craftvia/craftvia-core-s-g431/docs/images/2D_PCB1_front_2026-10-26.png

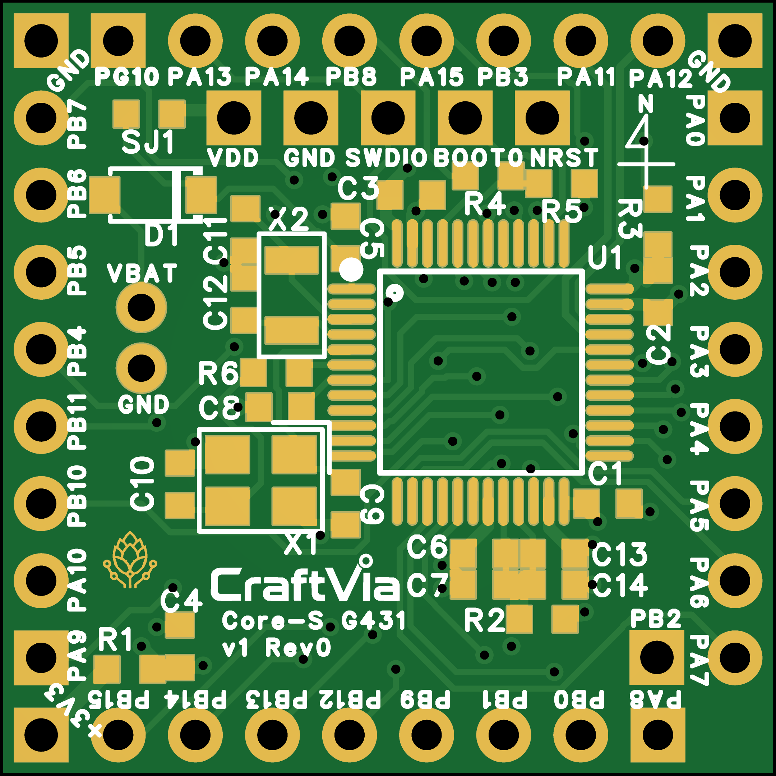
docs/images/2D_PCB1_front_2026-10-26.png
