craftvia/craftvia-core-s-g431/assembly/CraftVia-Core-S-G431-v1-Rev0-Assembly.pdf

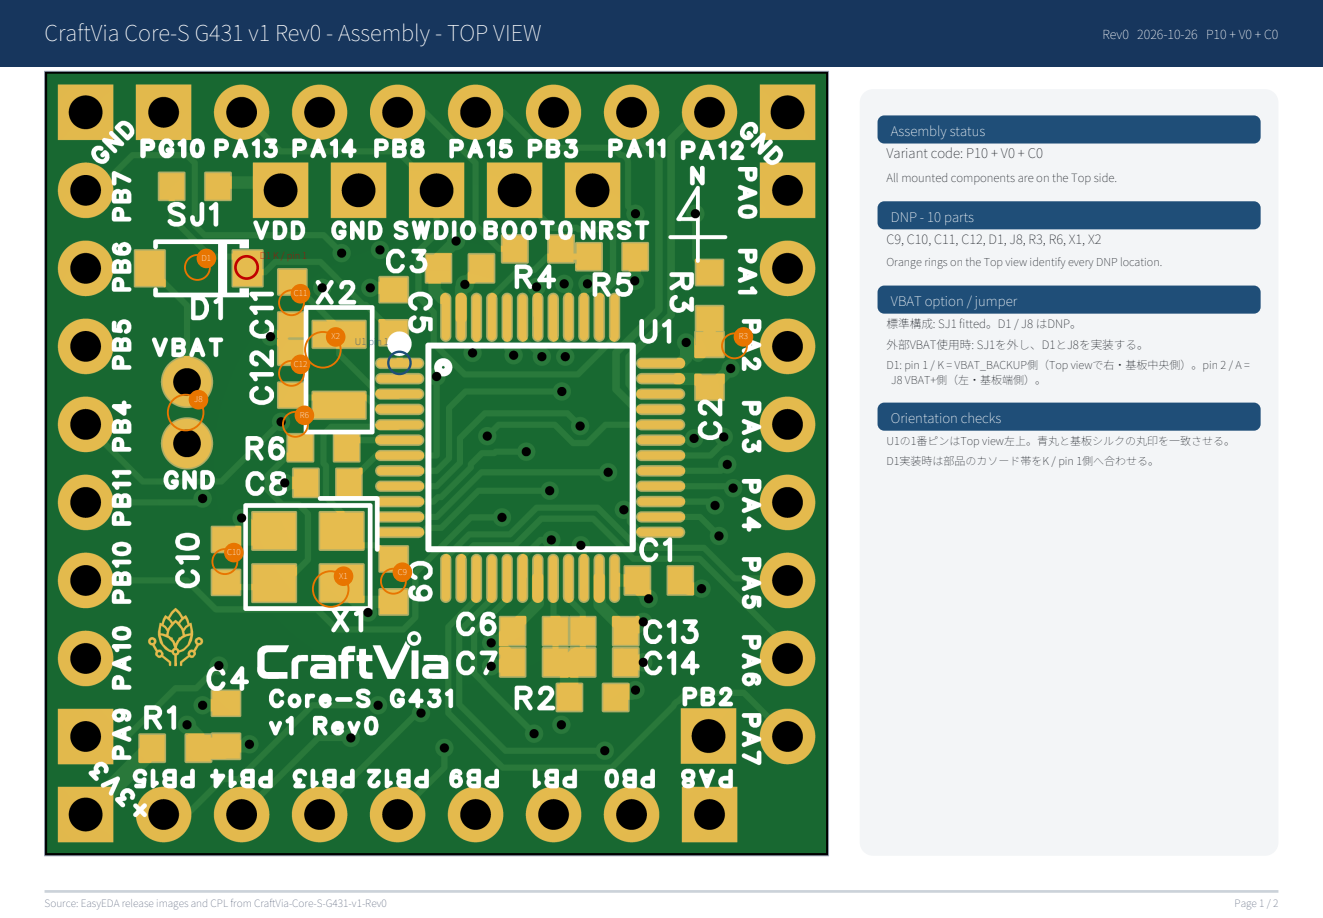
[picture p4: page 1]

All mounted components are on the Top side.

Orange rings on the Top view identify every DNP location.

標準構成: SJ1 fitted。D1 / J8 はDNP。
外部VBAT使用時: SJ1を外し、D1とJ8を実装する。
D1: pin 1 / K = VBAT_BACKUP側（Top viewで右・基板中央側）。pin 2 / A =
J8 VBAT+側（左・基板端側）。

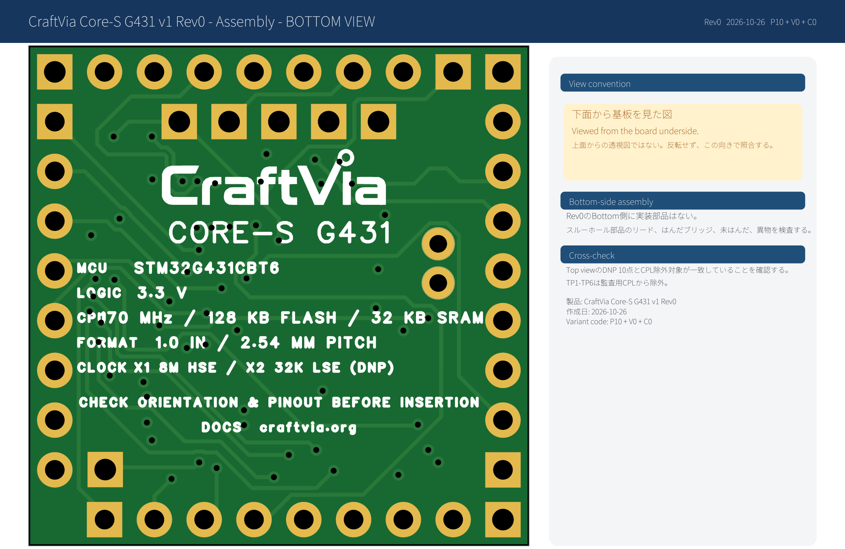
[picture p5: figure]
View convention; 下面から基板を見た図; Viewed from the board underside.; 上面からの透視図ではない。反転せず、この向きで照合する。; Bottom-side assembly; Rev0のBottom側に実装部品はない。; スルーホール部品のリード、はんだブリッジ、未はんだ、異物を検査する。; Cross-check; Top viewのDNP 10点とCPL除外対象が一致していることを確認する。; TP1-TP6は監査用CPLから除外。; 製品: CraftVia Core-S G431 v1 Rev0 作成日: 2026-10-26 Variant code: P10 + V0 + C0

CraftVia Core-S G431 v1 Rev0 - Assembly - BOTTOM VIEW | Rev0 2026-10-26 P10 + V0 + C0
Source: EasyEDA release images and CPL from CraftVia-Core-S-G431-v1-Rev0 | Page 2 / 2

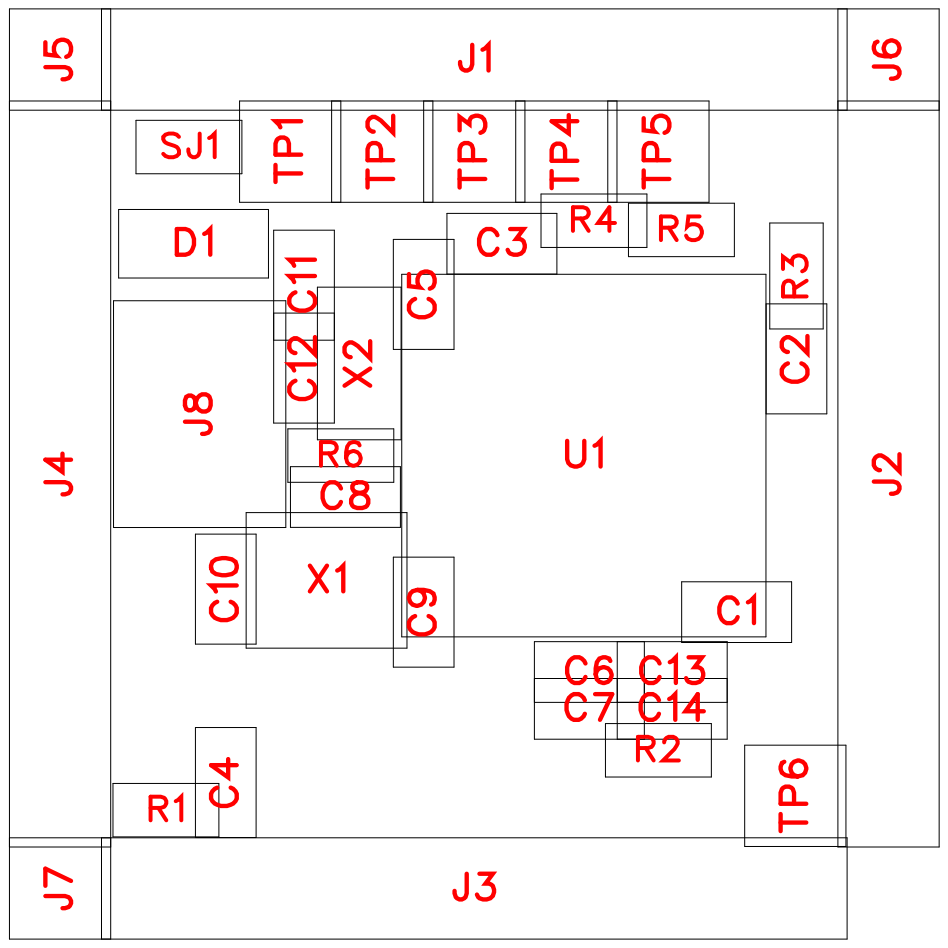
[picture p6: page 3]

C6 | C13
R2

No. | Quantity | Comment | Designator | Footprint | Value | Manufacturer Part | Manufacturer | Supplier Part | Supplier | LCSC Part Name
1 | 3 | 100nF VDD | C1,C2,C3 | C0603 | 100nF | CC0603KRX 7R9BB104 | YAGEO(国巨 ) | CC0603KRX 7R9BB104.1 | LCSC
2 | 1 | 4.7uF bulk | C4 | C0603 | 4.7uF | CL10A475K O8NNNC | SAMSUNG( ) 三星 | CL10A475K O8NNNC.1 | LCSC
3 | 1 | 100nF VBAT | C5 | C0603 | 100nF | CC0603KRX 7R9BB104 | YAGEO(国巨 ) | CC0603KRX 7R9BB104.1 | LCSC
4 | 1 | 100nF VREF+ | C6 | C0603 | 100nF | CC0603KRX 7R9BB104 | YAGEO(国巨 ) | CC0603KRX 7R9BB104.1 | LCSC
5 | 1 | 1uF VREF+ | C7 | C0603 | 1uF | CL10A105KB 8NNNC | SAMSUNG( 三星 ) | CL10A105KB 8NNNC.1 | LCSC
6 | 1 | 100nF NRST | C8 | C0603 | 100nF | CC0603KRX 7R9BB104 | YAGEO(国巨 ) | CC0603KRX 7R9BB104.1 | LCSC
7 | 2 | 18pF HSE load (DNP, tune) | C9,C10 | C0603 | 18pF | CL10C180JB 8NNNC | SAMSUNG( ) 三星 | CL10C180JB 8NNNC.1 | LCSC
8 | 2 | 10pF LSE load (DNP, tune) | C11,C12 | C0603 | 10pF | CL10C100JB 8NNNC | SAMSUNG( ) 三星 | CL10C100JB 8NNNC.1 | LCSC
9 | 1 | 100nF VDDA | C13 | C0603 | 100nF | CC0603KRX 7R9BB104 | YAGEO(国巨 ) | C14663 | LCSC | 100nF ±10% 50V
10 | 1 | 1uF VDDA | C14 | C0603 | 1uF | CL10A105KB 8NNNC | SAMSUNG( 三星 ) | CL10A105KB 8NNNC.1 | LCSC
11 | 1 | BAS116GWJ VBAT isolation (DNP) | D1 | SOD-123_L2 .8-W1.6-LS3. 7-RD | | BAS116GWJ | Nexperia( 安 世 ) | BAS116GWJ .1 | LCSC | 85V 215mA
12 | 1 | N 1-8 | J1 | HDR-TH_8P-P2.54-V-M | | 直排针2.54m m 1*8P | | Header2.54m m 1*8P.1 | LCSC
13 | 1 | E 1-8 | J2 | HDR-TH_8P-P2.54-V-M | | 直排针2.54m m 1*8P | | Header2.54m m 1*8P.1 | LCSC
14 | 1 | S 1-8 | J3 | HDR-TH_8P-P2.54-V-M | | 直排针2.54m m 1*8P | | Header2.54m m 1*8P.1 | LCSC
15 | 1 | W 1-8 | J4 | HDR-TH_8P-P2.54-V-M | | 直排针2.54m m 1*8P | | Header2.54m m 1*8P.1 | LCSC
16 | 1 | K-NW | J5 | HDR-TH_1P-P2.54-V-M | | 2.54-1*1P 针 | BOOMELE( 博穆精密 ) | Header-Male -2.54_1x1.1 | LCSC
17 | 1 | K-NE | J6 | HDR-TH_1P-P2.54-V-M | | 2.54-1*1P 针 | BOOMELE( 博穆精密 ) | Header-Male -2.54_1x1.1 | LCSC
18 | 1 | K-SW | J7 | HDR-TH_1P-P2.54-V-M | | 2.54-1*1P 针 | BOOMELE( 博穆精密 ) | Header-Male -2.54_1x1.1 | LCSC
19 | 1 | VBAT IN (PH 2.0mm) | J8 | CONN-TH_B 2B-PH-K-S | | XY-B2B-PH-K-S | XYECONN( ) 辛译 | XY-B2B-PH-K-S.1 | LCSC
20 | 1 | 0R / FB VDD | R1 | R0603 | 0R | 0603WAF00 00T5E | UNI-ROYAL( ) 厚声 | 0603WAF00 00T5E.1 | LCSC
21 | 1 | 0R / FB VDDA | R2 | R0603 | 0R | 0603WAF00 00T5E | UNI-ROYAL( 厚声 ) | 0603WAF00 00T5E.1 | LCSC

22 | 1 | 10k NRST pull-up (DNP) | R3 | R0603 | 10k | 0603WAF10 02T5E | UNI-ROYAL( 厚声 ) | 0603WAF10 02T5E.1 | LCSC
23 | 1 | 1k BOOT series | R4 | R0603 | 1k | 0603WAF10 01T5E | UNI-ROYAL( ) 厚声 | 0603WAF10 01T5E.1 | LCSC
24 | 1 | 10k BOOT pull-down | R5 | R0603 | 10k | 0603WAF10 02T5E | UNI-ROYAL( ) 厚声 | 0603WAF10 02T5E.1 | LCSC
25 | 1 | 0R HSE REXT start (DNP, tune) | R6 | R0603 | 0R | 0603WAF00 00T5E | UNI-ROYAL( 厚声 ) | 0603WAF00 00T5E.1 | LCSC
26 | 1 | 0R VBAT link (default fitted) | SJ1 | R0603 | 0R | 0603WAF00 00T5E | UNI-ROYAL( 厚声 ) | 0603WAF00 00T5E.1 | LCSC
27 | 1 | STM32G431 CBT6 | U1 | LQFP-48_L7. 0-W7.0-P0.5 0-LS9.0-BL | | STM32G431 CBT6 | ST(意法半导 体) | STM32G431 CBT6.1 | LCSC
28 | 1 | 8MHz HSE: SX32Y00800 0BC1T001 ( DNP/Optiona l) | X1 | CRYSTAL-S MD_4P-L3.2-W2.5-BL | 8.000MHz | SX32Y00800 0BC1T001 | TKD(泰晶 ) | SX32Y00800 0BC1T001.1 | LCSC
29 | 1 | 32.768kHz LSE: X1A000 1410001 (DN P/Optional) | X2 | OSC-SMD_L 3.2-W1.5 | 32.768kHz | X1A0001410 001 | EPSON(爱普 生) | FC-135R32.7 68kHz7.0pF2 0PPM.1 | LCSC

Description | Mounting Type

VREF+ local decoupling; place at U1 pin 20 with shortest return to VSSA pin 19

VREF+ local bulk decoupling; place at U1 pin 20 with shortest return to VSSA pin 19

HSE load capacitor nominal start value for X1 CL=12pF; tune for PCB stray capacitance and startup margin

LSE load capacitor nominal start value for X2 CL=7pF; tune for PCB stray capacitance and startup margin

VDDA local decoupling; place at U1 pin 21 with shortest return to VSSA pin 19

VDDA local bulk decoupling; place at U1 pin 21 with shortest return to VSSA pin 19

Optional low-leakage series isolation diode for external VBAT; populate for direct primary-cell use; anode to J8 VBAT+, cathode to VBAT_BACKUP

External VBAT input. Populate D1 and remove SJ1 before connecting a primary cell.

Optional external NRST pull-up; standard assembly DNP

Series REXT on OSC_OUT; start with 0R for bring-up, then verify drive level and negative-resistance margin

Default fitted: VBAT follows VDD_CORE; remove SJ1 and populate D1 before applying external VBAT via J8

Primary HSE crystal, SMD 3225 4-pin; standard assembly DNP; validate load, startup and drive level on PCB

Primary LSE crystal, Epson FC-135R 3215; standard assembly DNP; tune load capacitors and configure LSEDRV

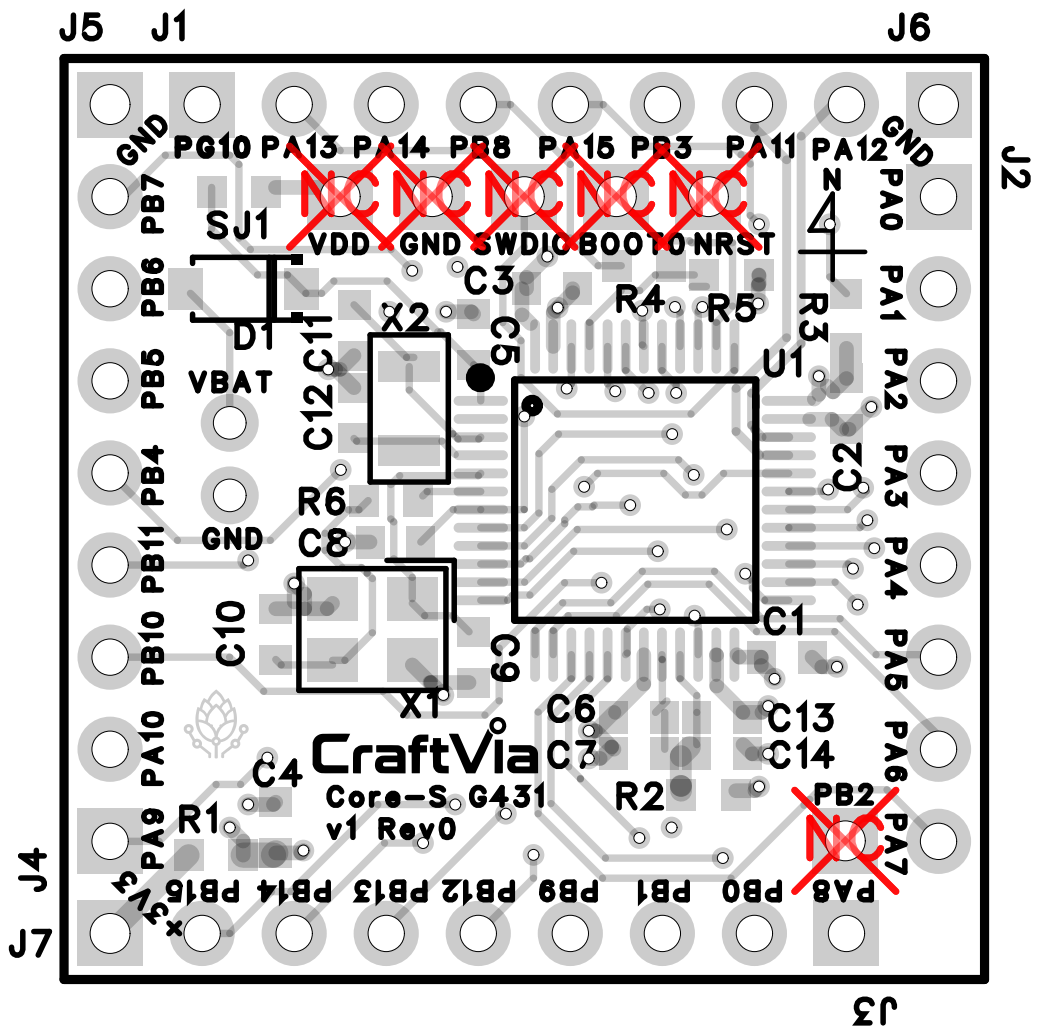
[picture p7: page 9]

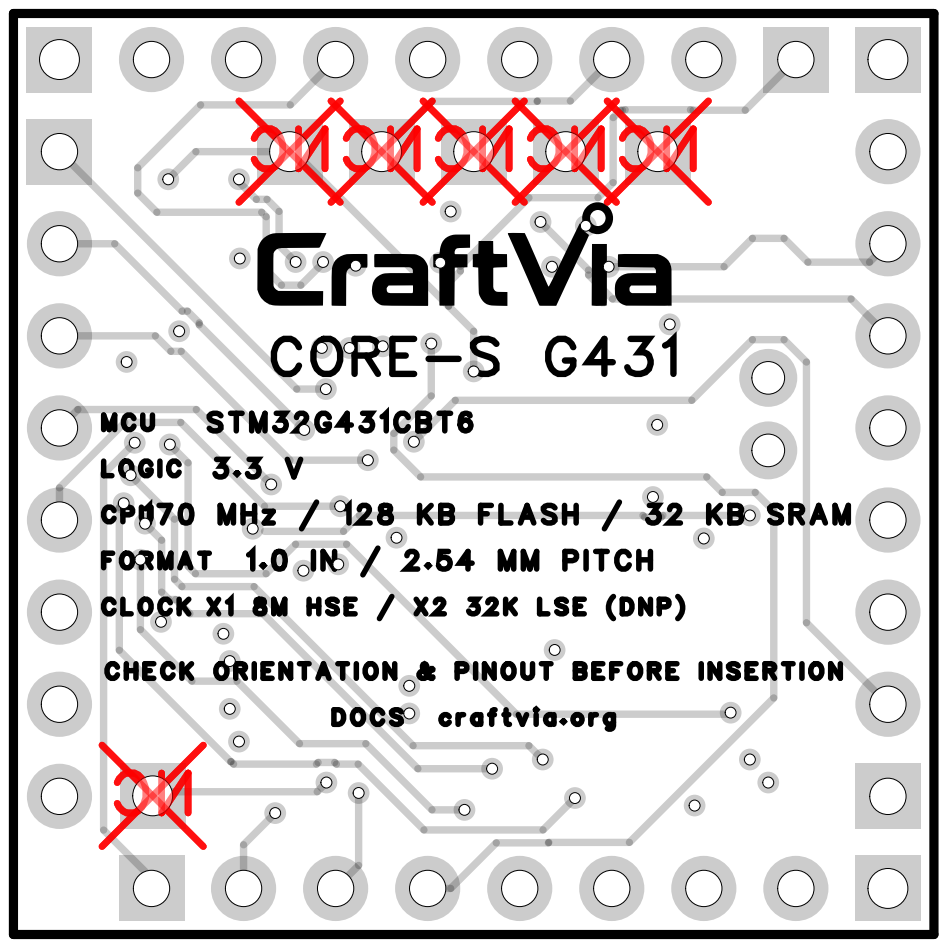
[picture p8: page 10]
CORE-S G431; LOGIC

MCU STM32G431CBT6
CPU170 MHz / 128 KB FLASH / 32 KB SRAM
FORMAT 1.0 IN / 2.54 MM PITCH
CLOCK X1 8M HSE / X2 32K LSE (DNP)
CHECK ORIENTATION & PINOUT BEFORE INSERTION

DOCS craftvia.org

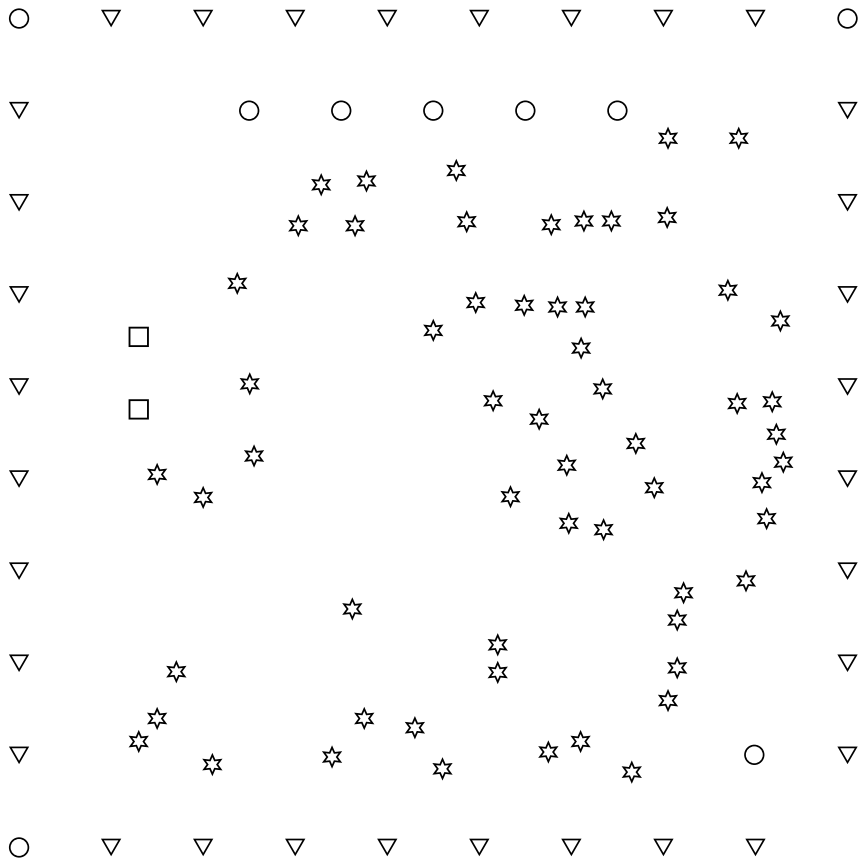
[picture p9: page 11]
