craftvia/craftvia-core-s-g431/docs/SCH_Core-S-G431-v1-Rev0_2026-10-26.pdf

PB15 29 PB14 28 PB13 27 PB12 26 PB11 25 PB10 22 PB9 46 PB8-BOOT0 45 PB7 44 PB6 43 PB5 42 PB4 41 PB3 40 PB2 18 PB1 17 PB0 16

# CraftVia Core-S G431 | v1 Rev0 - SCHEMATIC DRAFT

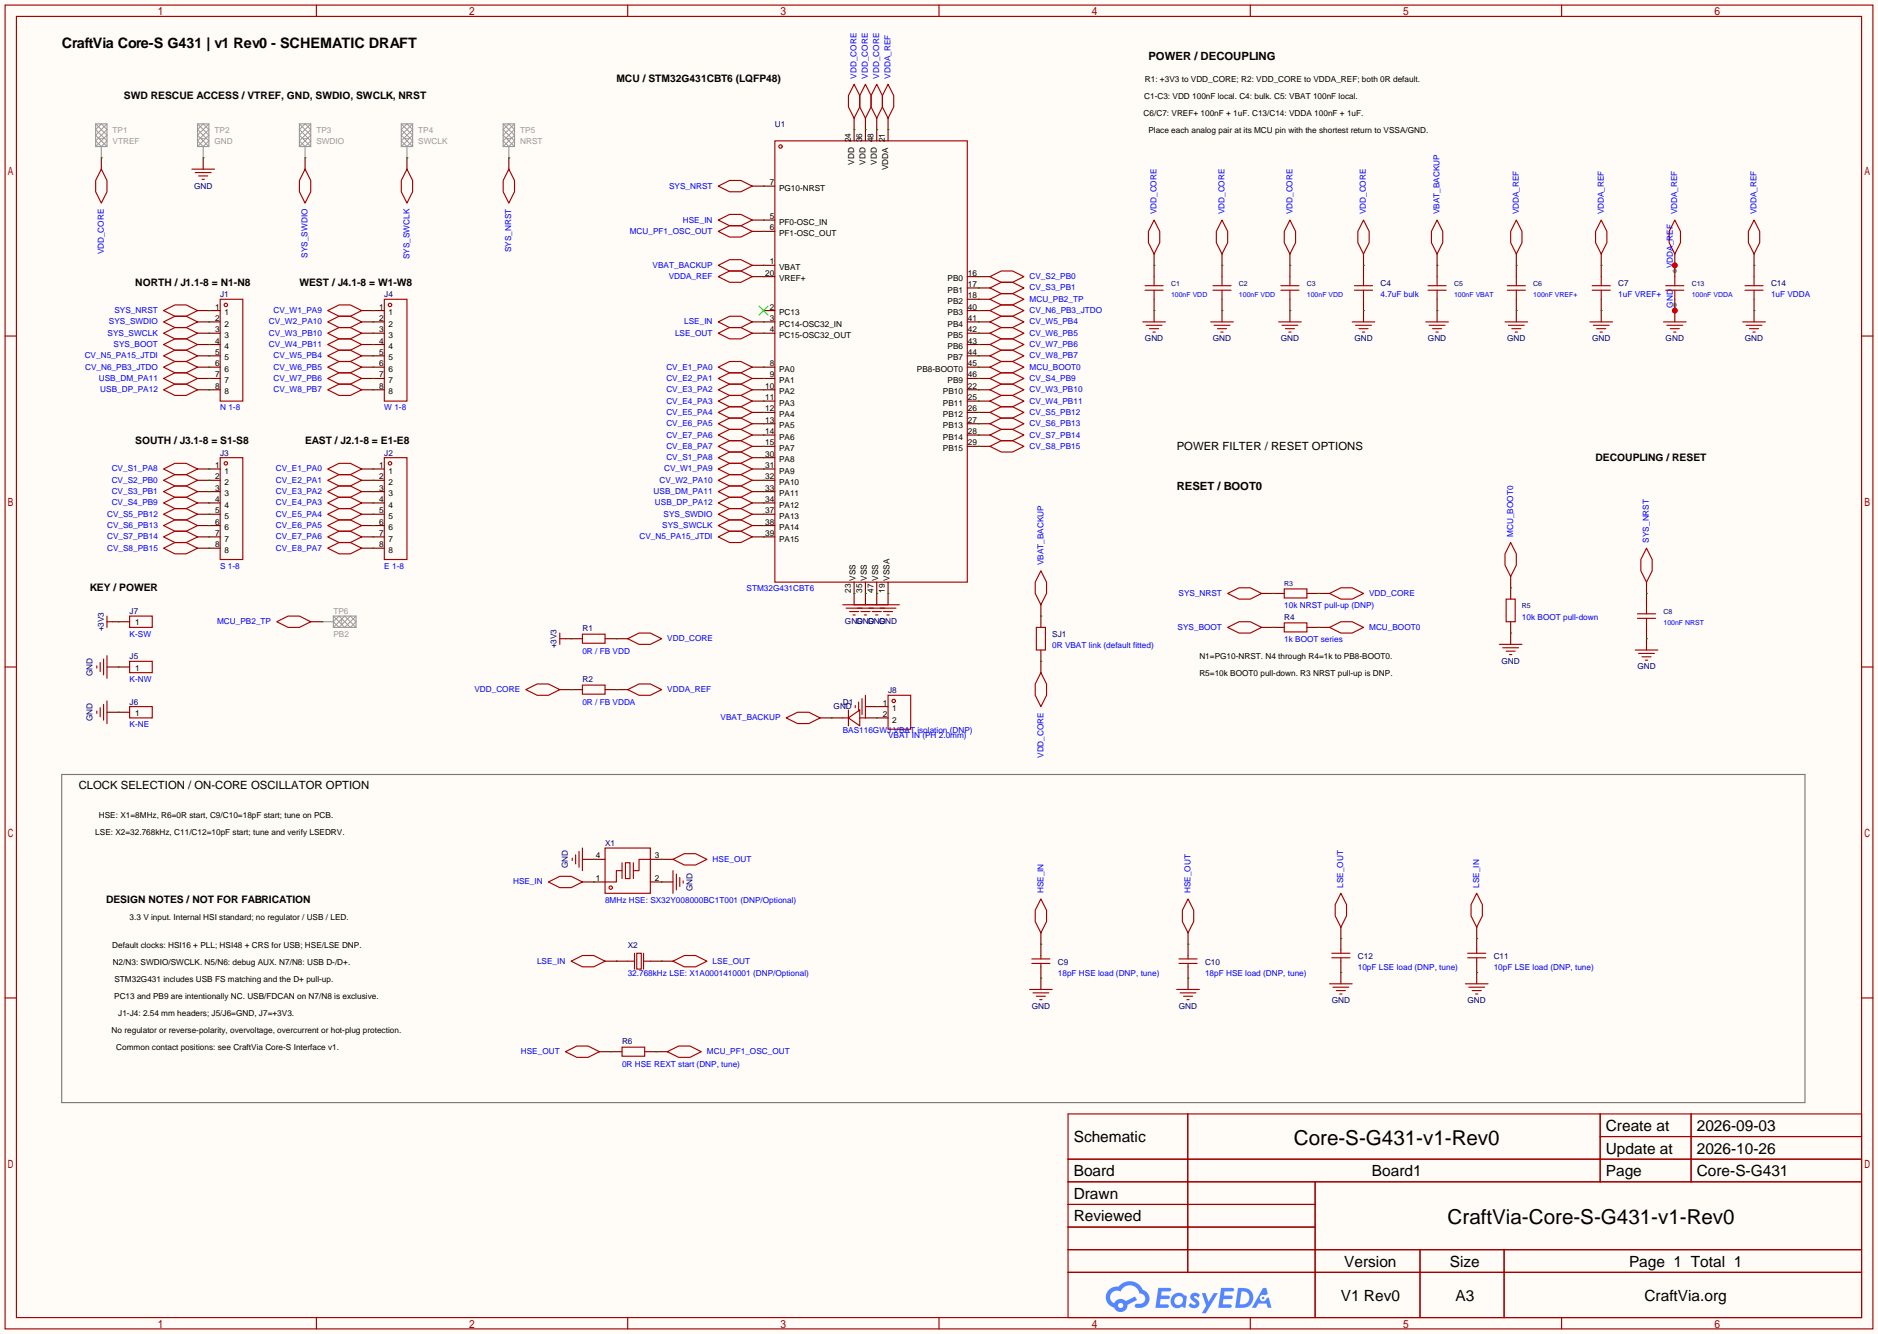
[picture p10: page 1]

R1: +3V3 to VDD_CORE; R2: VDD_CORE to VDDA_REF; both 0R default.
C1-C3: VDD 100nF local. C4: bulk. C5: VBAT 100nF local.
C6/C7: VREF+ 100nF + 1uF. C13/C14: VDDA 100nF + 1uF.
Place each analog pair at its MCU pin with the shortest return to VSSA/GND.

SWD RESCUE ACCESS / VTREF, GND, SWDIO, SWCLK, NRST

POWER FILTER / RESET OPTIONS

10k NRST pull-up (DNP)

0R VBAT link (default fitted)

N1=PG10-NRST. N4 through R4=1k to PB8-BOOT0.
R5=10k BOOT0 pull-down. R3 NRST pull-up is DNP.

CLOCK SELECTION / ON-CORE OSCILLATOR OPTION

HSE: X1=8MHz, R6=0R start, C9/C10=18pF start; tune on PCB.
LSE: X2=32.768kHz, C11/C12=10pF start; tune and verify LSEDRV.

DESIGN NOTES / NOT FOR FABRICATION
3.3 V input. Internal HSI standard; no regulator / USB / LED.

Default clocks: HSI16 + PLL; HSI48 + CRS for USB; HSE/LSE DNP.
N2/N3: SWDIO/SWCLK. N5/N6: debug AUX. N7/N8: USB D-/D+.
STM32G431 includes USB FS matching and the D+ pull-up.
PC13 and PB9 are intentionally NC. USB/FDCAN on N7/N8 is exclusive.
J1-J4: 2.54 mm headers; J5/J6=GND, J7=+3V3.
No regulator or reverse-polarity, overvoltage, overcurrent or hot-plug protection.
Common contact positions: see CraftVia Core-S Interface v1.

18pF HSE load (DNP, tune)

10pF LSE load (DNP, tune)

0R HSE REXT start (DNP, tune)

Schematic | Core-S-G431-v1-Rev0 | Create at | 2026-09-03

Update at | 2026-10-26

Board | Board1 | Page | Core-S-G431
Drawn | | CraftVia-Core-S-G431-v1-Rev0
Reviewed

Version | Size | Page 1 Total 1
V1 Rev0 | A3 | CraftVia.org
