craftvia/craftvia-core-s-g431/(list of files, drawings)

Other design files:
source/ProPrj_CraftVia-Core-S-G431-v1-Rev0_2026-10-26.epro
