craftvia/craftvia-core-s-g431/(commit log)

2026-11-10 Prepare Core-S G431 v1 Rev0 publication
    [BOM_Board1_PCB1_2026-10-26.csv, PickAndPlace_PCB1_2026_10_26.csv, ProPrj_CraftVia-Core-S-G431-v1-Rev0_2026-10-26.epro]
2026-11-10 Record Rev0 boards as ordered
